arthru-vinicius/bettacare/apps/web/assets/betta-lancador-1024.png

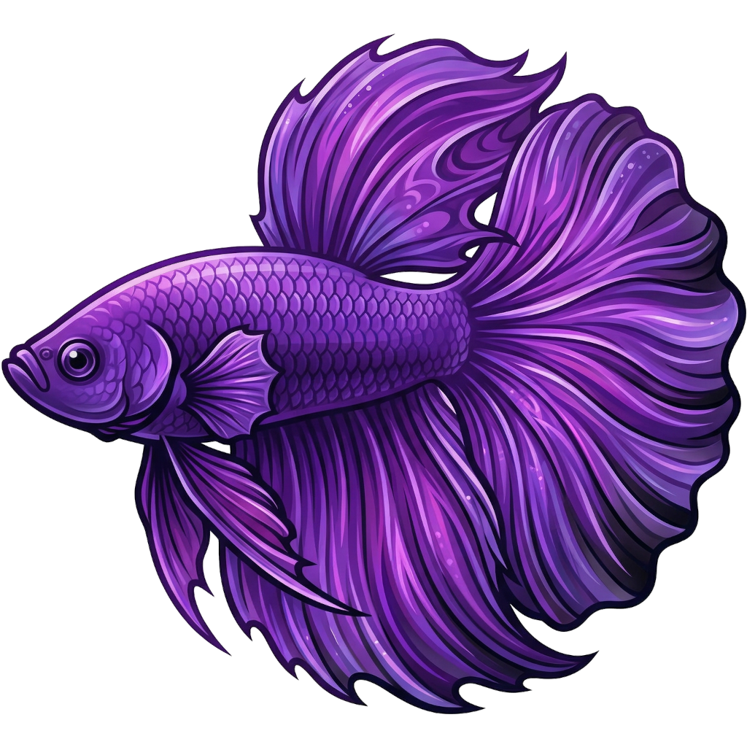
apps/web/assets/betta-lancador-1024.png
