arthru-vinicius/bettacare/apps/web/assets/betta-carregando-1024.png

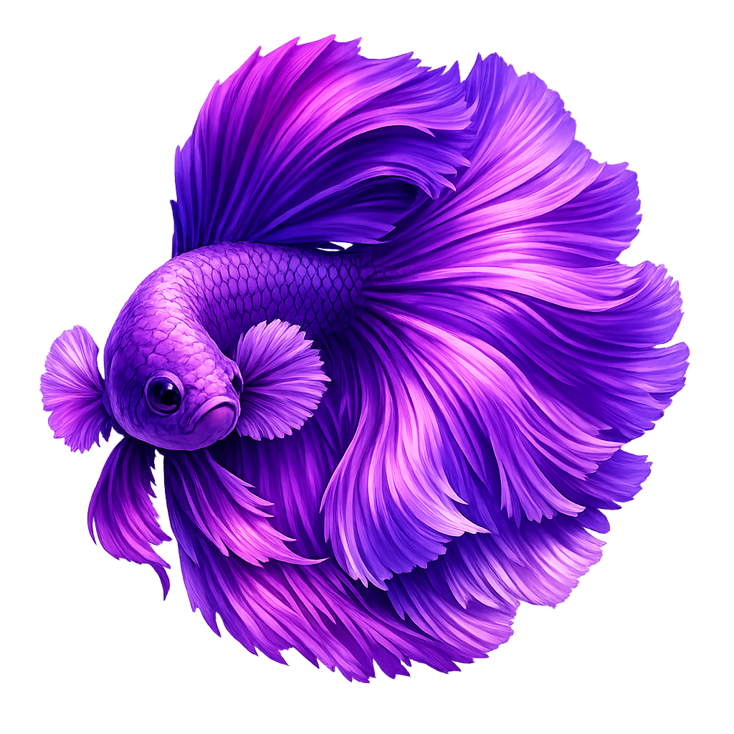
apps/web/assets/betta-carregando-1024.png
