arthru-vinicius/bettacare/docs/api-servidor.md

# API do servidor

Referência das duas superfícies HTTP do BettaCare. Escrita para quem vai
implementar o firmware (Fase 3) e a interface (Fase 4).

Os schemas são a autoridade: tudo aqui é validado por `@bettacare/contract`.

---

## Porta 8080 — o ESP32

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

### Respostas de erro

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

### Tamanhos medidos

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

O contrato do homelab pede corpo pequeno e previsível; o teto que assumimos é
300 bytes.

---

## Porta 3000 — a interface

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

### `GET /api/events`

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

### `GET /api/history/fan`

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

| Parâmetro | Valores | Nota |
|---|---|---|
| `range` | `24h` (padrão), `7d`, `30d` | qualquer outro → `400 invalid_range` |

```jsonc
{
  "range": "24h",
  "from": "2026-10-21T04:44:00.000Z", "to": "2026-10-22T04:44:20.000Z",
  "bucket_s": 60,            // largura de cada ponto
  "gap_s": 150,              // silêncio que interrompe a linha
  "points": [[1792557840, 24.75, 24.70, 24.80], …],   // [início s Unix, média, mín, máx]
  "temperature": { "min": 23.4, "min_at": "…", "avg": 25.9, "max": 29.0, "max_at": "…" },
  "runs": [{ "id": 12, "started_at": "…", "ended_at": null, "duration_s": 1380,
             "mode": "auto", "manual": false, "speed_max": 60,
             "temp_start": 29.1, "temp_end": null, "temp_peak": 29.3, "temp_low": 28.4,
             "approx": false }],
  "runs_total": 3,
  "summary": { "runs": 3, "on_seconds": 6720, "avg_duration_s": 2700, "avg_drop_c": 1.5 }
}
```

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

### `POST /api/commands`

Corpo é uma ação do contrato:

```jsonc
{"action":"light.set","on":true}
{"action":"fan.set_speed","percent":60}
{"action":"fan.set_mode","mode":"auto"}
{"action":"device.reboot"}
```

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

Um comando vive `COMMAND_MAX_AGE_S` (15 min) a partir da criação: até lá ele é
(re)entregue a cada POST, mesmo depois de `sent`, até o `ack` chegar. O
`GET /api/commands` traz `expires_at` — até quando ele ainda pode ser
executado — para a interface dizer "na fila até 14:17". Vencido, vira
`expired` com `cmd.stale_discarded` (nunca entregue) ou `cmd.expired`
(entregue sem confirmação). Quando o dispositivo reinicia com
`feeder.feed_now` ou `device.reboot` ainda `sent`, eles não são reentregues: o
reboot é confirmado e a alimentação encerrada como `cmd.interrupted`.

### `PUT /api/settings`

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

### `GET /api/export/*.csv`

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

---

## Cabeçalhos de cache

Onde a briga da atualização do PWA é ganha. Como o Hono serve os arquivos, eles
são nossos — sem depender de CDN nem de proxy, que aliás estão proibidos.

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

---

## Processos de segundo plano

Dois `setInterval` dentro do próprio processo. Não há worker, fila nem cron do
sistema.

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

### Saúde medida por tempo

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

### Acionamentos da ventoinha (`fan_runs`, v1.4.0)

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

### Saúde: avisos que não ficam para sempre

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

### Corpo com problema

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

### Temperatura

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

### Bloco `feeder`

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

---

## Verificado de ponta a ponta

O que foi exercitado contra Postgres 17 real, simulando o ESP32 com `curl`:

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
