arthru-vinicius/bettacare/docs/pinagem-e-montagem-esp32.md

# Pinagem e Montagem — ESP32-WROOM-32D

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

> **Revisado em 2026-08-21.** A versão anterior deste guia continha três erros
> de projeto que produziam falhas intermitentes e silenciosas — o resistor de
> 220 Ω na entrada do SSR, o PWM da ventoinha em push-pull, e o pull-up do
> 1-Wire tratado como opcional. O raciocínio completo, com as medições e as
> especificações que sustentam cada correção, está em
> [`UPGRADE/02-hardware-e-ligacoes.md`](../UPGRADE/02-hardware-e-ligacoes.md).
> Aqui fica só o "como montar".
>
> **Atualizado em 2026-10-01**, depois da montagem em bancada: corte de energia
> da ventoinha no `GPIO26` (o `GPIO27` queimou), botão lido por amostragem e
> não mais por interrupção (§2), enlace com o alimentador implementado do lado
> do ESP32 (§8) e o firmware de debug para investigar defeitos sem tirar o
> ESP32 da placa ("Depois de montar").

O módulo opcional de alimentação de precisão (rosca doseadora + sensor de
contagem) tem pinagem própria, num ESP32-C3 Super Mini separado — ver
[`pinagem-alimentador-modulo.md`](./pinagem-alimentador-modulo.md). Este
documento só trata dos dois pinos do lado do ESP32 que interligam os dois
módulos (seção 8).

---

## Aviso de segurança (AC)

O `SSR-40DA` comuta tensão de rede (`127 V / 220 V AC`).

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

---

## Pinagem

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

> **Interligação com o módulo do alimentador** — ver §8. `GPIO4` e `GPIO16` não
> conflitam com nenhum dos nove acima nem com *strapping*/flash. O lado do
> ESP32 principal já está implementado (`feeder_link.cpp`); o que falta é o
> firmware do próprio módulo.

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

---

## Lista de componentes

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

> **Sai da montagem antiga:** o resistor de 220 Ω entre o GPIO23 e o `SSR +`.

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

---

## 1. Alimentação

A lacuna mais séria da montagem anterior. O ESP32 consome picos de centenas de
miliampères durante a transmissão Wi-Fi, em rajadas de poucos milissegundos.
Um capacitor de 100 nF não sustenta rajada nenhuma — ele filtra ruído, não
entrega energia. Sem reservatório, cada transmissão puxa o trilho para baixo, e
se a queda cruzar o limiar do detector de brownout **o chip reinicia**.

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

### Fonte única (recomendado)

```text
Fonte 12V ──┬──────────────────────► +12V da ventoinha (pino 2)
            │
            └──► Buck (MP1584/LM2596) ──► 5V ──► VIN do ESP32
```

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

### Desacoplamento

```text
3V3 ──┬────────────┬──────────► DS3231, DS18B20, potenciômetro
      │            │
    470µF        100nF
      │            │
GND ──┴────────────┴──
```

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

### Terra em estrela

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

---

## 2. Push button (GPIO18)

```text
GPIO18 ──┬──── botão ──── GND
         │
       100nF
         │
        GND
```

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

> **Por que não interrupção na borda.** Era assim até 2026-10-01, e foi a causa
> do relé que mudava de estado sozinho a cada ~5 s (UPGRADE/07). O fio do
> `GPIO18` corre ao lado do `GPIO19`, o 1-Wire do DS18B20, e cada bit-slot do
> 1-Wire induz um pico de microssegundos no botão: medidos 16 picos no pedido
> de conversão e 152 na leitura, a cada 5 s — milhares por hora. A interrupção
> aceitava qualquer borda como toque, e o debounce de 50 ms não segurava nada
> porque o loop roda a cada 200 ms. Com a amostragem, os picos continuam
> chegando e não fazem diferença: em 32 min de teste, 62.909 picos e só as 4
> trocas dos toques reais.
>
> O 100 nF não resolve sozinho — com ele a 9 cm do pino, os picos chegavam do
> mesmo jeito. Afastar os fios do 18 e do 19 reduziria o acoplamento, mas não
> é necessário com o firmware atual. Para conferir o ruído na sua montagem, o
> firmware de debug conta os picos e as trocas (ver "Roteiro de bancada").

---

## 3. DS3231 (RTC, I²C)

- `GPIO21` → `SDA`
- `GPIO22` → `SCL`
- `3V3` → `VCC`
- `GND` → `GND`

Os módulos DS3231 comuns já trazem pull-up de I²C embarcado.

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

---

## 4. Luminária (SSR-40DA)

O SSR-40DA aceita **3 a 32 V DC** no controle e consome até **7,5 mA**. A faixa
larga existe porque a entrada já é limitada internamente — **o SSR já tem o
resistor de que precisa, dentro dele.** Foi por isso que o resistor de 220 Ω da
montagem anterior saiu: ele não protegia nada e só tirava margem.

### Opção A — Robusta (recomendada)

MOSFET no lado baixo, SSR alimentado com 5 V:

```text
5V (VIN da placa) ─────────────────────► SSR +

                                         SSR - ──┐
                                                 │
                                               dreno
GPIO23 ──── 1k ──── gate  [2N7002 / AO3400]
                      │                   fonte
                    100k                    │
                      │                     │
GND ──────────────────┴─────────────────────┘
```

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

### Opção B — Mínima (custo zero)

GPIO23 direto no `SSR +`, sem resistor em série:

```text
GPIO23 ──┬──────────────► SSR +
         │
        10k
         │
GND ─────┴──────────────► SSR -
```

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

### Lado AC

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

### Se a lâmpada brilhar fraco quando deveria estar apagada

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

---

## 5. DS18B20 (temperatura, GPIO19)

```text
3V3 ──┬──── VCC (vermelho)
      │
     4k7
      │
GPIO19 ───┴──── DATA (amarelo)

GND ──────────── GND (preto)
```

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

> ### O pull-up não é opcional
>
> A versão anterior deste guia dizia "se o sensor não tiver pull-up embutido,
> adicionar 4,7 kΩ". Esse "se" causava montagens sem o resistor.
>
> O 1-Wire **não funciona sem pull-up** — a linha é de dreno aberto e o
> resistor é quem gera o nível alto. As sondas DS18B20 à prova d'água de três
> fios, que são as usadas em aquário, **normalmente não trazem resistor
> nenhum**; quem traz é o módulo de placa.
>
> Sem ele o barramento pode até dar leituras — flutuando pela capacitância
> parasita, em condições favoráveis — e depois parar quando o cabo é movido ou
> a umidade muda. É o retrato de "o sensor sumiu".
>
> **Como verificar:** com o ESP32 desligado, meça a resistência entre `DATA` e
> `3V3`. Circuito aberto significa que o resistor não existe.

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

---

## 6. Potenciômetro B10K (GPIO34)

```text
3V3 ────[lateral]   B10K   [lateral]──── GND
                 \         /
                  \ wiper /
                   GPIO34
                     │
                   100nF
                     │
                    GND
```

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

---

## 7. Ventoinha 12 V de 4 pinos

### Ligações por pino do conector

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

### Desacoplamento da linha de 12 V

```text
            +12V fonte
               │
               ├────[100nF]────┬────[10µF]──── GND
               │               │
               └───────────────┴──► Pino 2 (+12V)

GND fonte ────────────────────────► Pino 1 (GND)
       │
       └── terra comum ──► GND do ESP32
```

### Pino 4 (PWM) — exige dreno aberto

A norma da Intel (*4-Wire PWM Controlled Fans Specification*, rev. 1.3) é
explícita:

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

**Antes de ligar, faça esta medição** (é o método da própria norma, §2.2):

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

**Se der 5 V**, monte assim:

```text
Pino 4 da ventoinha ──── dreno
                                  [AO3400]
GPIO17 ──── 1k ──── gate
                      │            fonte
                    100k             │
                      │              │
GND ──────────────────┴──────────────┘
```

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

### Pino 3 (Tacômetro) — pull-up externo obrigatório

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

A montagem anterior usava só o pull-up interno do ESP32, de **~45 kΩ**. Com essa
resistência e a capacitância do cabo, a borda de subida fica lenta — e uma borda
lenta atravessando o limiar de comutação capta ruído, que está logo ali, na
chave de 25 kHz da própria ventoinha. Cada oscilação vira um pulso contado a
mais.

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

```text
3V3 ──┬──
      │
     4k7 (ou 10k)
      │
GPIO25 ──┴──── 1k ──┬──── Pino 3 (Tach)
                    │
                  10nF
                    │
                   GND
```

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

### Duas notas de comportamento

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

### Corte de energia (ventoinha Tipo A, que nunca desliga só pelo PWM)

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

```text
+12V fonte ──┬──────────────────────────────────► Pino 2 da ventoinha (verde)
             │
           catodo [1N4007]
             │
            anodo
             │
Pino 1 da ventoinha (preto) ──┬────────────────── dreno [AO3400]
                              │
GPIO26 ──── 1k ──── gate      │
                      │       │
                    100k      fonte
                      │         │
                     3V3        │
                                │
GND comum ───────────────────────┘
```

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

> **`GPIO27` era o pino original — queimou em campo** (UPGRADE/07). Causa mais
> provável: o AO3400 tem gate e dreno em pinos adjacentes no SOT-23, e um
> curto acidental de solda entre eles durante a montagem expôs o `GPIO27` a
> 12V através de só 1kΩ — tensão muito acima do que o pino aguenta. O resto do
> chip continuou saudável; só a saída daquele pino especificamente morreu.
> **Não reutilize o `GPIO27` pra nada neste projeto.** O firmware agora lê de
> volta o pino do corte (hoje o `GPIO26`) a cada 2 s e avisa uma vez por
> episódio se ele divergir do que foi escrito (`fan.power_pin_fault`, e
> `fan.power_pin_ok` quando volta) — é o retrato de pino queimado, pego na hora
> em vez de depois de dias de "a ventoinha não desliga".

---

## 8. Interligação com o módulo do alimentador (opcional)

O módulo de alimentação de precisão é fisicamente separado — RTC, botão e
display próprios, controlador próprio (ESP32-C3 Super Mini). Pinagem completa
dele em [`pinagem-alimentador-modulo.md`](./pinagem-alimentador-modulo.md);
aqui fica só o lado do ESP32.

Conector JST-XH de 4 vias, na **ordem física do conector usado nesta
montagem**:

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

A última coluna é do ESP32-C3 — chip diferente, numeração independente. Os
resistores ficam do lado do módulo; o porquê, e o resto da montagem dele, em
[`pinagem-alimentador-modulo.md`](./pinagem-alimentador-modulo.md), §7.

> **Sobre as cores:** não é a combinação "óbvia" (o costume seria vermelho no
> 12V), mas é a que veio no conector comprado. Os dois lados do cabo precisam
> ser crimpados com esta mesma correspondência de cor e pino — o conector é
> fêmea/macho e não força uma ordem única sozinho. Até 2026-10-01 o diagrama
> deste guia numerava `12V` como pino 1 e `GND` como pino 2; vale a ordem da
> tabela, que é a do conector montado.

- Por que `GPIO4`/`GPIO16` e não os pinos "padrão" da UART2 (`GPIO17`/`GPIO16`)?
  `GPIO17` já é o PWM da ventoinha (§7) — trocar de pino evita reabrir uma
  ligação já validada na bancada.
- Por que UART e não estender o I²C do RTC (`GPIO21`/`22`, já existe)? I²C não
  foi pensado pra atravessar um conector destacável — a capacitância do cabo
  prejudica a integridade do sinal nesse barramento. Serial tolera isso bem
  melhor e usa a mesma quantidade de fios.
- **Sem o cabo conectado, o alimentador continua funcionando sozinho** (RTC e
  agenda próprios) — a integração só existe pra centralizar agenda, health-check
  e histórico no servidor/PWA. Desse lado já está tudo pronto: o enlace no
  firmware do ESP32 principal, o servidor e o app.
- **O ESP32 detecta o módulo pelo próprio fio de dados**, sem fio a mais no
  conector (firmware 2.0.1). O `GPIO16` tem pull-down interno. Conector vazio
  é nível baixo; módulo ligado é nível alto, o repouso da UART dele. Sem módulo
  no fio, o ESP32 não manda nem `PING`, e o POST não leva o bloco do
  alimentador. Por isso **não ponha pull-up externo no `GPIO16`**, e, do lado
  do módulo, o resistor em série no TX dele fica em até 2,2 kΩ (ver
  [`pinagem-alimentador-modulo.md`](./pinagem-alimentador-modulo.md)).
- O enlace não tem checksum, e o `GPIO16` corre ao lado do PWM de 25 kHz no
  `GPIO17`. O pull-down também segura o fio vazio quieto (sem ele, vira
  antena), e o firmware descarta qualquer linha com campo fora da faixa do
  contrato — o próximo `PONG`, 2 s depois, traz o valor certo.

---

## Roteiro de bancada

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

A medição 8 é a que fecha o ciclo: o firmware agora reporta
`esp_reset_reason()` na telemetria, e é isso que transforma a suspeita de
brownout em fato — ou a descarta.

---

## Depois de montar

1. `cp config.example.h config.h` e preencha `WIFI_SSID`, `WIFI_PASSWORD`,
   `SERVER_HOST`, `SERVER_API_TOKEN`, `API_AUTH_TOKEN` e `OTA_PASSWORD`.
2. **Rotacione a senha de OTA.** A do repositório antigo esteve versionada em
   texto claro e deve ser considerada comprometida.
3. Grave, e rode o **diagnóstico geral** pela aba Diagnóstico do app: ele varre
   o barramento 1-Wire, sonda o I²C, testa a NVS, lê o ADC de ponta a ponta e
   devolve um relatório componente a componente.
4. Só depois de o diagnóstico passar limpo, energize o lado AC e instale no
   aquário.

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
