arthru-vinicius/bettacare/firmware/test/README.md

# Testes de host do firmware

Testes que rodam **no PC**, sem ESP32: cada `test_*.cpp` inclui o `.cpp` real
de `firmware/bettacare` e o compila com o `g++` comum, trocando o hardware por
stubs mínimos (`stubs/`). O que está sob teste é o código de produção, linha
por linha — não uma reimplementação dele.

```sh
sh firmware/test/run.sh
```

Precisa de um `g++` com C++17 no `PATH`. No Windows é o MinGW; no Linux, o `g++` do sistema. Os binários vão para
`firmware/test/build/`, que o `.gitignore` já cobre.

## O que cobrem

| Teste | Arquivo do firmware | Cenários |
|---|---|---|
| `test_rtc.cpp` | `rtc_manager.cpp` | Automação no boot; leitura de hora válida porém errada sem trocar a luz; virada real confirmada na leitura seguinte; três falhas de I²C derrubando o módulo; sem NTP a automação espera, com NTP segue pela hora do ESP32; módulo reencontrado pela sondagem; bytes inválidos (o "40:08") descartados; sincronização por NTP; reaplicação imediata e config nova confirmada |
| `test_feeder.cpp` | `feeder_link.cpp` | `PONG`, `SCHEDULE` e `FED` válidos; campos fora da faixa do contrato descartando a linha inteira; dígito corrompido; idade `-1` e idade absurda; idade envelhecendo entre `PONG`s; timeout, lixo que não reconecta, reconexão; linha gigante e CRLF; campo mais longo que o buffer não virando dois campos; formato de `FEED`/`CFG`; presença no fio: conector vazio sem `PING`, módulo plugado com `PING` a cada 2 s, cabo arrancado desconectando na hora, o 0x00 do *break*; limite de refeições: `FEED ... FORCE`, refeições em 24 h no `PONG`, `FED` com motivo e origem, cada `DENIED` virando o seu evento |
| `test_fan.cpp` | `fan.cpp` | Desligar cortando a energia **e** soltando a linha de PWM; o complemento do duty ao ligar; o pot parado que não assume depois de um comando; o pot girado assumindo em 400 ms sem passar pelo mínimo; a velocidade acompanhando o giro com um evento só no fim; o mínimo desligando; subir do mínimo; volta ao automático pelo app; pico de ruído isolado e deriva lenta do ADC que não assumem |
| `test_command_dedupe.cpp` | `command_dedupe.cpp` | Primeira chegada executa; reentrega antes do desfecho espera; depois do `ack`, a reentrega devolve o mesmo desfecho sem executar; recusa lembrada com o código; recusado antes de entrar (fila cheia) também lembrado; `id` 0 nunca casa com posição vazia; o mais antigo esquecido depois de 16; código longo truncado |
| `test_outage_tracker.cpp` | `outage_tracker.cpp` | Sucesso sem queda e queda curta sem resumo; período contado desde o último sucesso, com falhas por tipo e faixa de RSSI; apagão de 5h48 com o Wi-Fi caído (tempo sem Wi-Fi, quedas, motivo); trechos sem Wi-Fi separados que não somam o intervalo; buffer pequeno sem estouro; código de erro de rede das "outras" falhas e memória mínima do período, sem herdar do período anterior |
| `test_net_watchdog.cpp` | `net_watchdog.h` | Reassociar só depois de 2 min de POSTs falhando e nunca duas vezes em 5 min; o prazo do reinício dobrando de 2 h até o teto de 24 h; reiniciar só com a luminária apagada (o apagão de 21 h com a luz acesa espera apagar); um boot recém-feito sem "horas de silêncio"; reinícios seguidos esperando cada vez mais |
| `test_temperature.cpp` | `temperature.cpp` | O -48,00 de produção (0xFD00) descartado com o scratchpad no evento; salto de 7 °C segurado, relido na hora e descartado; mudança real de 3 °C confirmada pela releitura; 85,0 de power-on com o evento próprio; três leituras impossíveis derrubando o sensor; sensor reencontrado; CRC ruim isolado sem evento |

Foi rodando estes testes que apareceu o bug do campo longo partido em dois no
enlace do alimentador — o teste ao vivo não pegaria: na época o módulo nem
existia. O firmware do módulo tem os testes de host dele, em `firmware/feeder-module/test/`.

## Como funcionam os stubs

| Stub | Substitui | Controle que o teste ganha |
|---|---|---|
| `Arduino.h` | core do Arduino-ESP32 | `millis()` avança por `g_millis`; `String` mínima; `Serial`/`Serial2` falsos com entrada injetável e saída capturada; mutex que sempre concede; `g_pin` (o que `digitalWrite` escreveu), `g_ledc` (o duty de cada PWM) e `g_adc` (o que `analogRead` devolve) |
| `esp_arduino_version.h` | versão do core | o 3.x da bancada (`ledcAttach`/`ledcWrite` por pino) |
| `Wire.h` | barramento I²C | registradores de minuto e hora do DS3231, erro de transação programável |
| `RTClib.h` | RTClib | `begin()`/`lostPower()`/`adjust()` sobre o `Wire` falso |
| `OneWire.h`, `DallasTemperature.h` | barramento e biblioteca do DS18B20 | scratchpad devolvido (temperatura a 1/16 °C), CRC ruim, sensor ausente, contagem de conversões |
| `driver/gpio.h` | ESP-IDF | `g_gpio_level`: o nível lido no pino (o fio do alimentador com e sem módulo) |
| `esp_task_wdt.h` | ESP-IDF | nada a controlar — só existe para compilar |

O resto do que o `.cpp` sob teste chama de outros módulos (`event_log`,
`light_set`, `device_config_snapshot`…) é definido no próprio teste, que
registra as chamadas para conferir depois — é assim que um teste sabe que a
luz trocou, ou que um evento saiu.

## Acrescentando um teste

Um módulo entra aqui quando a lógica dele é decisiva e as dependências de
hardware são poucas. O caminho é o mesmo dos existentes: criar
`test_<modulo>.cpp`, incluir `"<modulo>.cpp"`, definir o que ele chama dos
outros módulos e, se ele tocar hardware novo, acrescentar só o stub mínimo
para compilar. O `run.sh` acha o arquivo novo sozinho.

Ao mudar o firmware, rode os testes **antes** de gravar no ESP32: são segundos,
contra minutos de compilação e gravação por OTA.
