arthru-vinicius/bettacare/(commit log)

2026-08-04 Handoff inicial do BettaCare
    Reescrita completa do smart-aquarium-system sob o nome BettaCare. Traz do
    repositório anterior apenas o que continua valendo:
    - firmware/bettacare/ — sketch do ESP32 (pasta e .ino renomeados), ainda com o
    transporte MQTT atual, que será substituído por HTTP na Fase 3
    - docs/ — pinagem e montagem do hardware, contrato de infraestrutura do
    homelab, respostas ao checklist do servidor e plano de migração
    Ficam para trás o servidor PHP, o PWA vanilla e o guia de deploy em EC2/Nginx.
    Higiene para repositório público:
    - config.example.h sanitizado (senha de OTA real trocada por placeholder;
    a credencial no dispositivo precisa ser rotacionada)
    - ende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
2026-08-05 Reescrita completa: monorepo, servidor, firmware HTTP e PWA
    Substitui o smart-aquarium-system (PHP + MQTT, sem banco) por um monorepo
    pnpm + Turborepo com quatro partes:
    - packages/contract: fonte única do contrato em Zod, para ESP32 e navegador.
    No sistema antigo o formato do JSON estava escrito à mão em três lugares e
    os três já divergiam entre si.
    - apps/server: Hono em duas portas — UI na 3000 (alcançada pelo cloudflared)
    e ingest do ESP32 na 8080 (bind explícito na LAN). Ingest idempotente por
    device_state.last_seq, fila de comandos com ciclo de vida completo, saúde
    por componente e dois jobs de fundo.
    - firmware/bettacare: MQTT vira HTTP e a rede sai para uma ta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
2026-08-05 Distinguir servidor fora do ar de controlador sem contato
    A interface tinha um único estado de erro e uma única mensagem. Enquanto o
    ESP32 não tinha feito o primeiro POST, `/api/overview` respondia 404
    `device_not_found` — o servidor dizendo que está de pé e não conhece o
    aquário — e o app anunciava "Sem contato com o servidor", apontando o dedo
    para a peça que estava funcionando.
    Passam a existir três estados, porque são três causas com três ações
    diferentes:
    - servidor inalcançável → "Sem contato com o servidor"
    - servidor ok, sem device → "Aguardando o primeiro contato do aquário"
    - device conhecido, mudo → "Sem contato com o controlador do aquário desde H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
2026-08-06 Corrigir 500 no ingest causado por sentinela que não cabia na coluna
    O firmware mandava UINT32_MAX em temperature.age_ms como sentinela de
    "nunca houve leitura válida". O Zod aceitava — z.int().min(0), sem teto —
    e a coluna integer recusava. A exceção subia dentro da transação e o
    ingest respondia 500 a todo POST enquanto o sensor estivesse sem leitura,
    que é justamente quando mais se quer saber o que está havendo. O
    dispositivo lia aquilo como "o servidor quebrou" e reenviava para sempre.
    Confirmado com dois corpos idênticos contra o servidor, só o age_ms
    diferente: 4294967295 devolve 500, 1200 devolve 200.
    A correção tem duas camadas. A de cima: a idade de uma leitura que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
    [api_client.cpp]
2026-08-07 Separar a arte do lançador da arte de abertura
    As duas artes estavam trocadas onde mais aparece. Os hashes mostravam a
    mistura: icon-192 era a ilustração vetorial (certa), mas icon-512 e
    apple-touch-icon eram o render fotorrealista — e são justamente esses dois
    que o Android e o iOS usam na tela inicial. Por isso a arte de abertura
    aparecia na gaveta de apps.
    Os papéis são diferentes por desenho, não por preferência: a ilustração
    vetorial tem contorno limpo e continua legível a 48 px, que é o tamanho
    real de um ícone instalado; o render fotorrealista tem gradiente e
    detalhe fino, que viram mingau nesse tamanho e só se pagam em tela cheia.
    O maskable virou arquivo próprio e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
2026-08-07 Especificar a CLI de deploy do homelab
    Amadurece a ideia de um `homelab update bettacare` no PATH do servidor,
    para o agente do homelab implementar.
    O ponto central é o enquadramento: a ferramenta não "atualiza", ela troca
    a versão fixada e prova que o serviço continua de pé — e desfaz sozinha se
    não continuar. Um script que roda `up -d` e imprime "pronto" reporta que o
    Docker aceitou o comando, não que a aplicação subiu.
    Documenta as quatro decisões que não são óbvias: ordenar por semver e não
    por data (o registro devolve as tags fora de ordem e com `sha-*` no meio),
    verificar `/healthz` em vez de confiar no código de saída, guardar a tag
    anterior, e não fazer nada sem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
2026-10-02 Firmware: botão por amostragem, watchdog do loop e relógio conferido
    O relé que trocava sozinho a cada ~5 s era o firmware: os bit-slots do
    1-Wire no GPIO19 induzem picos de microssegundos no GPIO18, e a interrupção
    do botão aceitava qualquer borda como toque. O botão passa a ser amostrado
    por timer a cada 2 ms, com 30 ms estáveis para valer.
    - Watchdog também no loop de controle, e o da task de rede reconfigurado
    (o init falhava calado e o prazo real era 5 s).
    - DS3231 lido direto dos registradores, com conferência de I²C e BCD: o
    RTClib decodificava lixo da pilha quando a leitura falhava. Três falhas
    seguidas dão o módulo como ausente, a automação segue pela hora do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
2026-10-02 Contrato: alimentador, diagnóstico do controlador e saneamento tolerante
    - Componente "feeder", estado do alimentador na telemetria e as ações
    feeder.feed_now e feeder.set_config.
    - Bloco diag (reset, heap, falhas de API e NVS, OTA, eventos perdidos),
    relatório de autodiagnóstico e device.diagnose.
    - Notificações push: inscrição e payload.
    - Saneamento: item inválido de events ou diagnostic.checks sai sozinho em vez
    de derrubar o POST inteiro, e cada correção leva o valor recebido para o
    log — 136 POSTs foram perdidos em produção por um comp "feeder".
    - Configuração recusa horário de acender igual ao de apagar (a luz ficaria
    acesa o dia inteiro).
    - Overview com a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
2026-10-02 Servidor: saúde por tempo, planilhas, alimentador e migrations 0004–0008
    - Saúde mede anomalia por tempo, não por POSTs seguidos (5 s; botão, 30 s):
    com a telemetria a 1 s, toda partida da ventoinha viraria falha com push.
    - O "desejado" da luminária só vale enquanto a última mudança veio do
    comando: o botão físico e a automação geravam light.state_mismatch falso
    (300 num dia em produção).
    - component_status só é regravado quando muda status, código ou início de
    anomalia, ou a cada 5 s — eram onze upserts por POST.
    - /healthz responde 503, não 500, com o banco fora, e o prazo do select 1
    passou a valer (SET LOCAL agora dentro de transação).
    - Exportação p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
2026-10-02 PWA: editores de horário e limites, ventoinha clara e aba Registros
    - Luminária: tocar em "Acende" ou "Apaga" abre o editor de horário — o
    servidor aceitava PUT /api/settings, mas a interface não tinha como chamar.
    - Ventoinha e temperatura: status primeiro, temperatura que abre o editor dos
    limites, botão Ligar/Desligar que troca de texto e "Voltar ao automático"
    habilitado só no manual. Tocar parado no slider não tira mais do
    automático. O histórico de temperatura mora aqui.
    - Registros junta Logs e Relatórios: período, nível, filtros extras
    recolhidos, lista por dia com detalhes ao toque e download das planilhas
    com os mesmos filtros.
    - Saúde: ajuste da frequê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
2026-10-02 Documentação: bancada, API, PWA e a rodada de confiabilidade
    - UPGRADE/: a auditoria de 2026-08-21 e o registro das rodadas de bancada
    (2026-10-01) e de servidor, banco e PWA (2026-10-02).
    - Pinagem: botão por amostragem e o porquê, GPIO26 no corte da ventoinha,
    conector do alimentador na ordem física montada, notas de rtc.bad_read e
    temp.reset_value, e o firmware de debug para investigar antes de ressoldar.
    - Módulo alimentador: aviso sobre o GPIO11 (VDD_SPI no ESP32-C3) e botão por
    amostragem.
    - API: rotas de planilha, período nos registros, saúde medida por tempo e
    saneamento por item.
    - PWA: estrutura nova das telas, editores e consulta mais frequente.
    - Firmware: watc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
2026-10-02 CI: testes com Postgres de verdade e lockfile do web-push
    - turbo.json declara DATABASE_URL na tarefa de teste. O turbo filtra o
    ambiente, então os testes de ingest, rollup e upgrade eram pulados em
    silêncio no CI, com o serviço postgres do workflow subindo para nada.
    - pnpm-lock.yaml com o web-push das notificações.
2026-10-02 Contrato: alimentador desconectado não valida nem grava o resto do bloco
    Com feeder.connected falso, só o connected conta: o resto do bloco é
    descartado antes de validar. O firmware 2.0.0 mandava o bloco inteiro
    zerado sem módulo, e "0 grãos" abaixo do mínimo virava uma correção (e um
    evento) por POST em produção; hour1/hour2 zerados sobrescreviam a agenda.
    O pot.out_of_range ganha texto honesto para os registros antigos: era
    alarme falso, o ADC satura em 4095 no fim do curso.
2026-10-02 Servidor: correções agrupadas, potenciômetro sem alarme falso e migration 0009
    - O mesmo campo corrigido de novo dentro de 1 h soma repeat_count no
    ingest.field_rejected aberto em vez de abrir outro; só a abertura sai
    como warn no log, as repetições vão para debug.
    - Leitura isolada do potenciômetro não é mais defeito: o topo do curso
    satura o ADC em 4095 em qualquer montagem boa (UPGRADE/02, §8).
    - 0009, só dados: limpa a agenda 00h/00h que os zeros do firmware 2.0.0
    gravaram, restrita ao aquarium-01 e à assinatura exata. Idempotente.
2026-10-02 PWA: leitura do potenciômetro nos extremos do curso
    "fim do curso" e "no mínimo" ao lado do valor do ADC, para 4095 não
    parecer defeito.
2026-10-02 Documentação: v1.1.1
    Tabela de regras de saúde alinhada ao código, correções agrupadas, o bloco
    feeder e o registro da rodada pós-deploy em UPGRADE/07.
2026-10-02 Firmware 2.0.1: alimentador só com o módulo no fio
    O RX do enlace (GPIO16) passa de pull-up para pull-down: conector vazio é
    nível baixo, módulo ligado é nível alto (o repouso da UART dele). Sem
    módulo no fio, o ESP32 não manda nem PING; com o cabo arrancado, desconecta
    na hora em vez de esperar 6 s de silêncio.
    O POST só leva o bloco feeder com o módulo conectado — a 2.0.0 mandava o
    bloco inteiro zerado, e "0 grãos" virava um evento de correção por POST em
    produção. /status mostra feeder.present para conferir na bancada.
    Testes de host do enlace: de 24 para 37 verificações. Cópia de debug
    sincronizada.
2026-10-02 Alimentador: montagem do módulo reorganizada para durar
    Nada estava soldado, então a pinagem inteira foi refeita:
    - botão sai do GPIO11 (VDD_SPI, que alimenta a flash; a Super Mini nem o
    expõe) para o GPIO5;
    - enlace na UART0 (GPIO20/21), com 4,7 kΩ e 1 kΩ em série: o GPIO21 solta
    o log do ROM no boot, e os resistores protegem a ligação a quente e
    mantêm a detecção do módulo pelo principal (TX ≤ 2,2 kΩ);
    - LED IR ligado por GPIO só na dosagem, com autoteste antes de cada
    refeição;
    - motores com pull-down na base, 1N5819 e PWM (o 1027 é de 3 V); servo com
    pull-down no sinal, sem tranco no boot;
    - alimentação pelo cabo ou por fonte própria, com diodos em "ou",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
2026-10-02 Contrato: faixas de temperatura da água e os avisos do termômetro
    TEMP_PLAUSIBLE_C (10–45 °C): fora disso a leitura é defeito, nunca
    temperatura — em produção, dois -48,00 °C isolados, um quadro de 1-Wire
    que passou no CRC. TEMP_USUAL_C (16–33 °C): fora disso a leitura é real,
    mas sai do gráfico e vira aviso com duração e pico.
    Códigos novos: temp.implausible, temp.spike_discarded e
    temp.out_of_usual_range.
2026-10-02 Servidor: leitura impossível descartada, episódios fora da faixa e migration 0010
    - O ingest confere a faixa possível de novo: a leitura impossível não
    chega ao estado, ao histórico, à saúde nem ao gráfico, e vira
    temp.implausible, agrupado por hora como as correções.
    - Água fora da faixa habitual vira um aviso por episódio nos Registros,
    com duração, horário e pico. O caso comum não custa consulta.
    - O rollup do gráfico só agrega a faixa habitual.
    - 0010, só dados: tira o -48 do histórico e refaz a hora que ele
    contaminou. Idempotente.
2026-10-02 PWA: o gráfico diz que mostra só a faixa habitual
    E aponta os Registros para o que ficou fora, com a duração.
2026-10-02 Firmware 2.0.2: termômetro descarta leitura que passou no CRC mas é lixo
    - Fora de 10–45 °C, a leitura é descartada e conta como falha, com os 9
    bytes crus do scratchpad no evento (temp.implausible).
    - Salto de mais de 2 °C só vale se a releitura, feita na hora, confirmar
    (temp.spike_discarded se não).
    - A leitura usa o endereço achado na sondagem: getTempCByIndex refazia a
    busca no 1-Wire a cada conversão.
    Teste de host novo do termômetro (21 verificações), com stubs do OneWire e
    do DallasTemperature. Cópia de debug sincronizada.
2026-10-02 Documentação: termômetro, alimentador e a rodada pós-v1.1.1
    O que o firmware 2.0.1/2.0.2 e o servidor fazem com a temperatura e com o
    alimentador, e o registro da rodada em UPGRADE/07.
2026-10-02 Servidor: a 0010 só mexe no impossível
    Revisão do homelab-c4, com dry-run em produção: refazer as horas antigas
    pela regra habitual (16–33 °C) apagaria em silêncio o extremo de uma hora
    quente ou fria de verdade, sem o aviso temp.out_of_usual_range, que só
    existe a partir desta versão. A 0010 agora refaz só as horas com leitura
    fora de 10–45 °C, e só sem o impossível. Em produção, o resultado é o
    mesmo: a hora 2026-10-01 23:00Z, com média 27,08 nas 98 amostras boas.
    samples segue sendo a contagem de linhas brutas da hora, no job e na
    migration — explícito agora no schema.
2026-10-02 Firmware 2.0.3: ventoinha desligada de verdade e potenciômetro que responde
    - Desligar solta a linha de PWM. O corte é no retorno, e o complemento de
    0% deixava o MOSFET do buffer prendendo o pino 4 no GND: a ventoinha,
    sem o próprio terra, voltava por ali — 3 a 7 V nos terminais e giros aos
    trancos, com o GPIO26 corretamente em 0 V. Ao religar, o duty é escrito
    antes da energia.
    - O pot é lido a cada volta do loop, na média de 8 conversões (era uma a
    cada 500 ms com um filtro de ~6 s), e assume o comando quando girado —
    não só depois de ir ao mínimo e subir, de novo a cada boot, comando do
    app e virada da agenda. Ruído isolado e deriva do ADC não assumem.
    - pot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
2026-10-02 Documentação: ventoinha desligada, potenciômetro e o AO3400 do PWM
    O buffer do PWM desta montagem é um AO3400, não um 2N7002; por que a
    linha fica solta com a energia cortada, e como conferir no multímetro.
2026-10-02 Documentação: o que a ventoinha desligada mostra no multímetro
    Com o corte no retorno, o pino 1 flutua: ~3,3 V estáveis entre os pinos 1
    e 2, sem giro, são fuga medida por um multímetro de 10 MΩ, não corrente.
    O corte limpo seria no +12V, registrado para quando a placa for refeita.
2026-10-02 PWA: lint de volta, com o ESLint direto (o next lint saiu no Next 16)
    eslint + eslint-config-next (Core Web Vitals e TypeScript) em
    eslint.config.mjs, como a documentação do Next 16 manda. Corrigidos os
    dois achados reais: o Sheet atualizava uma ref durante o render (agora
    useEffectEvent) e a tela do alimentador chamava Date.now() no render (agora
    formata a idade, que já vem em segundos). A regra set-state-in-effect fica
    como aviso: são dez padrões intencionais, que só se refatoram com calma e
    navegador.
    O pnpm 11 recusava o install sem decidir o script do unrs-resolver; ele
    fica negado, porque o binário nativo já vem pela dependência opcional.
    [pnpm-lock.yaml]
2026-10-02 Documentação: listas de verificado e não verificado em dia
    A interface atual (Registros no lugar de Logs e Relatórios, histórico na
    tela da Ventoinha), o push no ghcr, o deploy e o Cloudflare Access
    verificados em produção, e onde está a série de memória do ESP32.
2026-10-02 Contrato: limite de 3 refeições em 24 h no alimentador
    FEEDER_MEALS_PER_24H, meals_24h no bloco feeder e force no feeder.feed_now
    — o app pode alimentar além do limite de propósito; o botão do módulo
    nunca. Eventos novos: limit_reached, limit_overridden, feed_denied,
    sensor_fault e hopper_empty.
2026-10-02 Servidor: refeições em 24 h e push dos avisos do alimentador
    - Migration 0011, aditiva: device_state.feeder_meals_24h, preservado como
    último conhecido quando o módulo sai do fio, e no overview.
    - Limite atingido, reservatório vazio e sensor com defeito tocam o
    celular; o que é erro fica até alguém ver.
2026-10-02 Firmware 2.1.0: o limite de refeições do alimentador no enlace
    FEED [grãos] [FORCE] repassa o "ignorar o limite" do app; DENIED
    LIMITE/OCUPADO, o motivo e a origem no FED (VAZIO, SENSOR) e as refeições
    em 24 h no PONG viram eventos e telemetria. Os campos novos são opcionais:
    um módulo antigo continua entendido. Testes de host do enlace: 47.
2026-10-02 Firmware 2.1.0: recusa por calibração e motivo desconhecido também avisam
    DENIED CALIBRAR (doseador sem calibração) vira feeder.feed_denied, e um
    motivo que este firmware não conhece também, com o nome que veio.
2026-10-02 Alimentador: refeição da agenda perdida vira aviso
    DENIED PERDIDA (atraso maior que 4 h, ou a próxima refeição perto
    demais) vira feeder.meal_missed: o peixe ficou sem aquela refeição, e
    alguém precisa saber.
2026-10-02 Alimentador 1.0.0-beta: o firmware do módulo inteiro
    Agenda, limite de 3 refeições em 24 h, recuperação até 4 h sem colar em outra refeição, doseador como máquina de estados com teto em cada motor, servo sem tranco, autoteste do sensor (reprovado, conta pelo servo), botão, tela, NVS, relógio conferido e o enlace com o principal na UART1.
    Console pela USB e pela rede (/console), log que sobrevive a reinício (/log) e o receptor para o Docker em tools/. Testes de host: 126 verificações.
2026-10-02 Documentação: montagem do alimentador em base, torre e topo
    O enlace na UART1 nos pinos da UART0, o sensor reprovado alimentando pelo servo, o que vai em cima e o que fica embaixo, os doze fios da torre, e o roteiro de bancada com os comandos do firmware.
2026-10-02 Documentação: modelagem 3D do alimentador
    Briefing para o modelador: conceito, regras que não mudam, o que entregar e como as peças serão aceitas; medidas iniciais com a conta das alturas; o doseador em detalhe; a ficha de medição do aquário; e dois croquis.
2026-10-02 Documentação: limite de refeições e o módulo do alimentador em beta
2026-10-03 Teste do rollup: limpa o dispositivo de teste inteiro
    O teste apagava só o "ontem" do dispositivo de teste, e o rollup pendente reagrega toda hora sem linha no telemetry_hourly: rodado de novo num outro dia, o ontem da rodada anterior somava em dobro (840 minutos de luz em vez de 420). A CI, com banco novo a cada vez, não via.
2026-10-14 Contrato: comando vale 15 min desde a criação e o Wi-Fi informa AP e canal
    DEFAULT_COMMAND_MAX_AGE_S (900) no lugar do TTL de 90 s contado da
    entrega: o comando é reentregue a cada POST até o ack, dentro dos 15 min
    — o que cobre 87% das quedas medidas no aquário. NON_REPEATABLE_ACTIONS
    (alimentar e reiniciar) não são reentregues a um boot novo. Telemetria
    com wifi.bssid, wifi.channel e wifi.last_disconnect_reason opcionais;
    overview com command_max_age_s e comandos com expires_at. Eventos novos:
    wifi.radio_restart, wifi.ap_pinned, wifi.ap_unpinned,
    wifi.pinned_ap_missing, api.outage_summary e cmd.interrupted.
2026-10-14 Servidor: comandos atravessam quedas de até 15 min e o push de sem contato espera 15 min
    - Comando `sent` não expira mais 90 s depois da primeira entrega: é
    reentregue a cada POST até o ack ou até COMMAND_MAX_AGE_S (900 s) desde
    a criação, com 2 min de folga para o ack de uma entrega no último
    minuto. COMMAND_TTL_S segue aceita e é ignorada.
    - Boot novo com alimentar ou reiniciar `sent`: reiniciar vira acked;
    alimentar vira cmd.interrupted — nunca ração em dobro.
    - device.offline segue em 60 s, mas o push só sai depois de
    DEVICE_OFFLINE_ALERT_AFTER_S (900 s), uma vez por queda; quando ele
    saiu, a volta manda "Controlador voltou" na mesma tag.
    - Saúde do Wi-Fi com h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
2026-10-14 PWA: comando na fila enquanto o aquário está sem contato
    Sem contato, o comando pendente vira "Na fila" (âmbar) com a hora em que
    expira, e o app continua acompanhando até o aquário confirmar
    ("Executado pelo aquário quando ele voltou") ou o prazo vencer. Polling
    rápido só com o aquário online. A aba Saúde mostra o AP e o canal do
    Wi-Fi.
2026-10-14 Firmware 2.1.1: Wi-Fi para enlace ruim, AP fixável e comando repetido sem executar de novo
    - Wi-Fi sem economia de energia, varredura de todos os canais escolhendo
    o AP mais forte, HT20 e 20 s sem beacon antes de desassociar (eram 6).
    - AP fixável no /wifi-setup, na lista com BSSID, canal e sinal; sem o
    fixado por 5 min, usa o mais forte e procura o fixado a cada 30 min.
    - Sem Wi-Fi por 10 min, o rádio é religado — sem reiniciar o ESP32, que
    perderia a luz manual.
    - Motivo da queda, BSSID e canal na telemetria; eventos de Wi-Fi retidos
    quando o POST falha; api.outage_summary depois de cada queda de 60 s
    ou mais.
    - Conexão HTTP mantida entre POSTs (7 s para conectar, 8 s para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
2026-10-14 Documentação: rede instável — fila de 15 min, push depois de 15 min e o Wi-Fi do 2.1.1
2026-10-22 Contrato: histórico da ventoinha e os códigos do vigia de rede
    - `history.ts`: o período (24h, 7d, 30d), a série de temperatura em tuplas
    [início, média, mínima, máxima], a rodada da ventoinha (ligou, desligou,
    duração, temperatura de partida/saída, pico, aproximada) e o resumo do
    período. É a superfície de GET /api/history/fan.
    - `system.event_overflow` deixa de culpar "um componente em rajada": o que
    enche o buffer de 24 eventos é o aquário sem rede.
    - Códigos novos do firmware 2.1.2: `wifi.api_stall_reassoc`,
    `system.net_watchdog_reboot` e `system.heap_low_water`.
2026-10-22 Servidor: acionamentos da ventoinha, histórico minuto a minuto e avisos que expiram
    - Tabela `fan_runs` (migration 0013): uma linha por rodada da ventoinha, aberta
    e fechada pelo ingest na transição de `fan.on`. Silêncio de mais de 5 min
    marca a rodada como aproximada, com o fim na última vez que se viu a
    ventoinha ligada. Índice parcial: no máximo uma rodada aberta por aparelho.
    A migration reconstrói uma vez as rodadas que já estão na telemetria.
    - Poda diária: o que passa de FAN_RUNS_RETENTION_DAYS (90) e de
    FAN_RUNS_MAX_ROWS (20 mil) sai; a rodada aberta nunca.
    - GET /api/history/fan?range=24h|7d|30d: temperatura da telemetria bruta (1 min,
    15 min ou 1 h, com míni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
2026-10-22 PWA: histórico interativo da temperatura, tabela de acionamentos e tempo aceso na Luminária
    - Aba Ventoinha: um seletor de período acima de dois cartões.
    - Temperatura da água: curva em que tocar, arrastar ou passar o mouse mostra
    o valor e o dia/hora exatos, acima do gráfico. O toque fixa, "Limpar" ou
    Esc soltam, as setas andam ponto a ponto, e a rolagem vertical da página
    segue valendo. Limites de liga/desliga (só perto da água), faixa de quando
    a ventoinha esteve ligada, silêncios como buracos, mínima/média/máxima que
    levam o cursor ao momento, e a mesma série em tabela.
    - Acionamentos da ventoinha: totais do período e a tabela de rodadas (ligou,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
2026-10-22 Firmware 2.1.2: vigia de rede, resumo de queda com memória e potenciômetro sem falso alarme
    Oito dias de produção mostraram que "o controlador cai" não é reinício (um
    só, power-on): em quase todos os 93 períodos sem contato o Wi-Fi seguiu
    associado com o POST expirando, e houve um apagão de 21 h em que nada do que o
    firmware fazia resolveu.
    - Reassocia o Wi-Fi depois de 2 min de POSTs falhando com ele associado (no
    máximo um a cada 5 min): limpa ARP, lease e sockets dos dois lados.
    - Reinício de último recurso após 2 h sem contato, só com a luminária apagada
    (reiniciar liga e desliga o relé, e o controlador dela troca de padrão). O
    prazo dobra a cada reinício seguid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
2026-10-22 Documentação: histórico da ventoinha, acionamentos e o diagnóstico das quedas
    - api-servidor: GET /api/history/fan, a tabela fan_runs (como abre, fecha e é
    podada), os avisos de saúde que expiram e o log de ingest lento.
    - pwa: a revisão de 2026-10-22 — gráfico com leitura exata, cartão de
    acionamentos, tempo aceso na Luminária e a cor própria da linha.
    - firmware: a 2.1.2 e o que os dados de oito dias mostraram (quedas de rede,
    não reinícios), inclusive o que eles não explicam: a troca de cor da
    luminária não sai do firmware.
    - arquitetura-observabilidade: retenção de fan_runs e a nova interface.
2026-10-22 PWA: a abertura do Android mostra a arte de carregamento, não o lançador
    O Android não tem campo de splash no manifest: o Chrome monta a abertura com
    `background_color` e um dos `icons`, preferindo os maskable — o mesmo grupo de
    onde sai o ícone da gaveta. Com o lançador como único maskable, ele aparecia
    grande (e cortado) na abertura.
    Agora são dois maskable, separados pelo tamanho que cada uso procura (83dp na
    gaveta, 128dp na abertura, vezes a densidade): o lançador em 332 px e a arte de
    carregamento em 512 px, com o peixe dentro do círculo central. A gaveta fica
    sempre com o lançador; a abertura mostra a arte de carregamento a partir de
    densidade 2,625 e, abaixo disso, o lan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
2026-10-22 Documentação: ícones e a tela de abertura do Android
2026-10-26 Contrato: comentários e testes deixam de citar os documentos de trabalho
    Os comentários de telemetry, primitives, api e codes apontavam para
    `UPGRADE/NN` e para `docs/pinagem-e-montagem-esp32.md`, que mudou de lugar.
    Tiradas as referências a `UPGRADE/`, o que sobra é a explicação em si; o
    caminho do guia de montagem agora é `docs/hardware/controlador-principal.md`.
    Só comentários e títulos de `describe`/`it` mudam, nenhum comportamento.
2026-10-26 Servidor: comentários e testes deixam de citar os documentos de trabalho
    Tiradas as referências a `UPGRADE/NN` dos comentários e dos títulos de teste,
    e atualizados os caminhos dos documentos que mudaram de nome
    (`docs/arquitetura.md`, `docs/api.md`, `docs/hardware/`), inclusive os números
    de seção citados: retenção é a §7 e o ciclo de vida do comando, a §3.
    Inclui o comentário do cabeçalho de `0000_inicial.sql`. É só comentário: o
    migrator do drizzle aplica por data, não pelo conteúdo do arquivo.
2026-10-26 PWA: comentários deixam de citar os documentos de trabalho
    Tiradas as referências a `UPGRADE/NN` e atualizados os caminhos de
    `docs/api.md` e `docs/hardware/modulo-alimentador.md`. Só comentários.
2026-10-26 Firmware: sai o sketch temporário e os comentários deixam de citar documentos de trabalho
    - Remove `firmware/debug-relay-fan`, o sketch de diagnóstico que isolava o
    GPIO23 e o corte da ventoinha durante a investigação do relé. Quem cumpre
    esse papel hoje é `firmware/bettacare-debug`, com o endpoint `/debug`.
    - Tira as referências a `UPGRADE/NN` dos comentários do principal, do debug e
    do módulo alimentador, e atualiza os caminhos de `docs/hardware/`.
    - Nos comentários do módulo alimentador, "o Arthur" vira "o usuário" e
    "decisões do Arthur" vira "decisões de projeto".
    Só comentários: os testes de host do firmware passam como antes.
2026-10-26 Documentação: docs/ reorganizado e o contexto de trabalho sai do repositório
    O contexto que ajudou a construir o projeto mas não descreve o produto passa
    para `memory/`, que fica fora do git (e fora da imagem): a rodada de
    confiabilidade (`UPGRADE/`), o contrato e a conversa com o servidor, o plano de
    migração, o briefing de modelagem 3D, o datasheet do ESP32 e o esquema do
    módulo de relógio. A proposta de TCC é removida de vez.
    `docs/` ganha estrutura e perde repetição:
    - README.md: porta de entrada, mapa de pastas e índice.
    - arquitetura.md: junta arquitetura-observabilidade com o comportamento do
    ingest que estava em api-servidor (saúde, dado ruim, acionamentos da
    ventoi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
2026-10-28 Firmware 2.1.3: a virada da agenda não desliga a ventoinha que o automático ligou
    Ao acender a luz pelo horário, fan_on_schedule_reset() reiniciava a máquina de
    estados da ventoinha mesmo com ela já no automático. O estado inicial só liga
    acima do gatilho e zera o resto, então uma ventoinha rodando entre o desligar
    (27,5 °C) e o gatilho (29 °C) parava no mesmo segundo, sem evento. Em
    produção, às 10:00 de 23 e 24/10, com a água a 28,8 e 28,3 °C; ela só religou
    ao voltar aos 29 °C, 37 e 110 min depois.
    Agora, já no automático, a máquina segue como está. Vinda do manual (app ou
    potenciômetro), a virada continua devolvendo a ventoinha ao automático.
    - fan.cpp, fan.h e o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
2026-10-28 Documentação: firmware 2.1.3 e o que 14 dias de telemetria dizem da luminária
    - A virada da agenda que desligava a ventoinha, e a correção.
    - O teste de host da ventoinha passa a 26 verificações; tamanho da imagem 2.1.3.
    - Luminária: de 14 a 28/10, todas as trocas de estado batem com o horário ou
    com o usuário, e os cinco reinícios foram com a luz apagada. O liga-desliga
    que troca a cor dela está fora do firmware (tomada, contato ou o SSR).
